aflyingcougar/elc-4438-wah-pedal/Submittal/Hardware Implementation/replacement_regulator.jpg

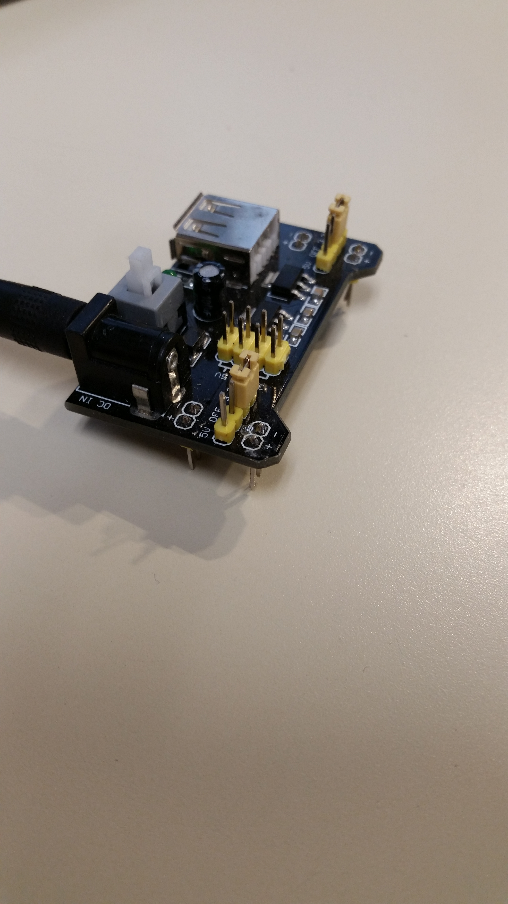
Submittal/Hardware Implementation/replacement_regulator.jpg
