aflyingcougar/elc-4438-wah-pedal/README.md

# elc-4438-wah-pedal
ELC 4438-01: Embedded Systems Final Project: DSP Wah Pedal
Contains design documentation and code implementation of a DSP wah pedal using a Teensy 3.2, a Teensy Audio board, and a re-purposed Dunlop Crybaby wah pedal enclosure.
