aflyingcougar/elc-4438-wah-pedal/Submittal/Source Code/readme.txt

See the Final Notes secion of the report for instructions on how to install/use Teensyduino.
