aflyingcougar/elc-4438-wah-pedal/Hardware Implementation/Hardware Implementation.docx

Hardware Implementation

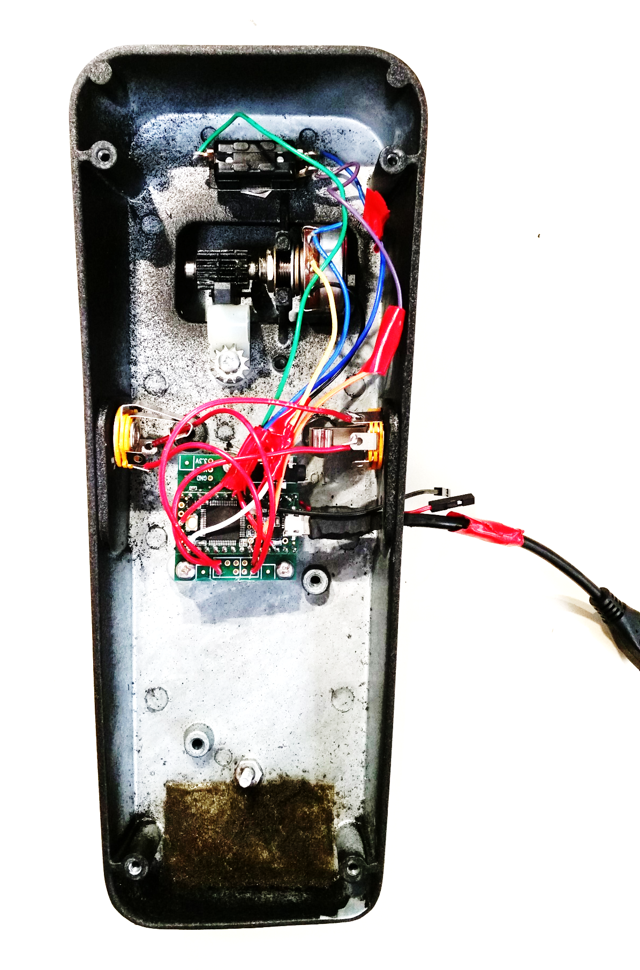
[picture p3: figure]

Switch

¼” Audio Jacks

Potentiometer

Power Supply Input

USB Cable

Teensy 3.2 and Audio Board Extension
