aflyingcougar/elc-4438-wah-pedal/Presentation/Final Presentation.pptx

## Wah Pedal

CJ Tulowiecki & Eric Walden

## What is a wah pedal?

- Electrical guitar effects pedal
- Name is an onomatopoeia, “wah-wah”
  - Mimics the human voice
- Moving pedal sweeps the cutoff frequency of a filter applied to input signal

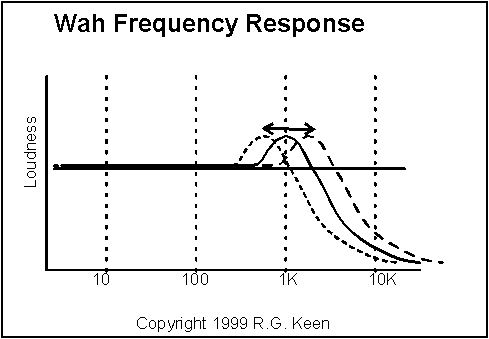
[picture p5: figure]
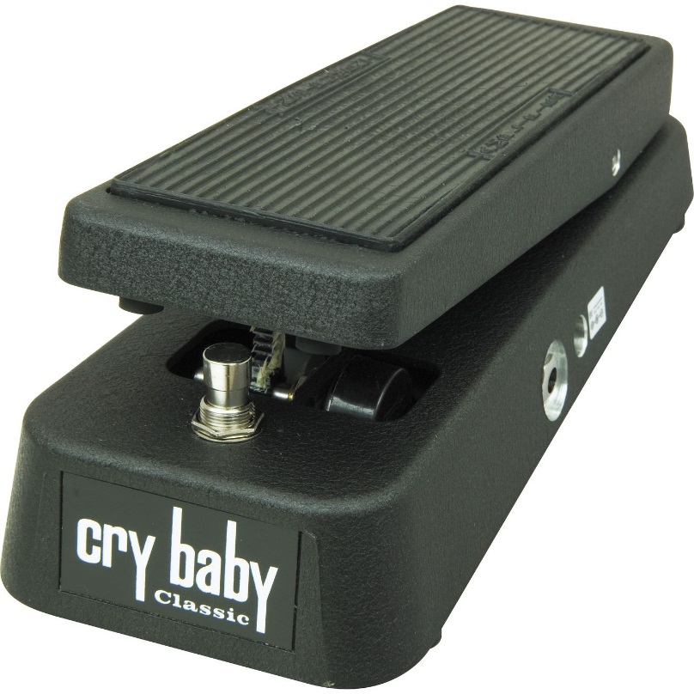
[picture p6: figure]

## Objectives

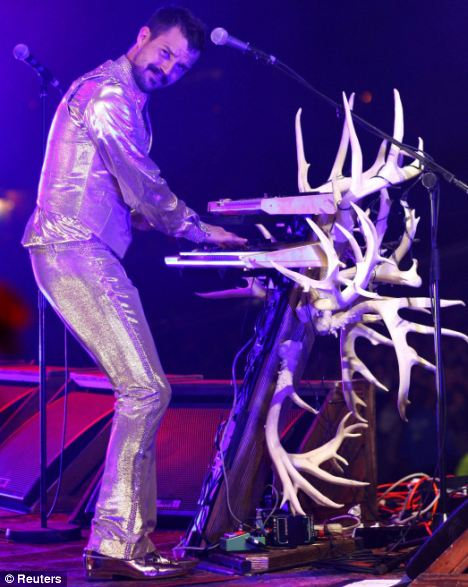
[picture p7: figure]

- Use a microcontroller to make a wah pedal
- Control cutoff frequency with the wah pedal’s potentiometer
- Learn about digital audio processing
- Make interesting sounds

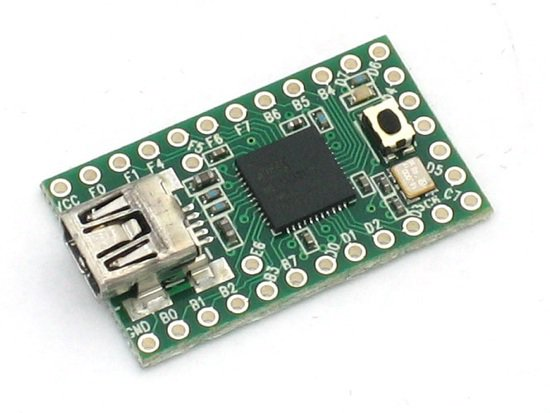
[picture p8: figure]
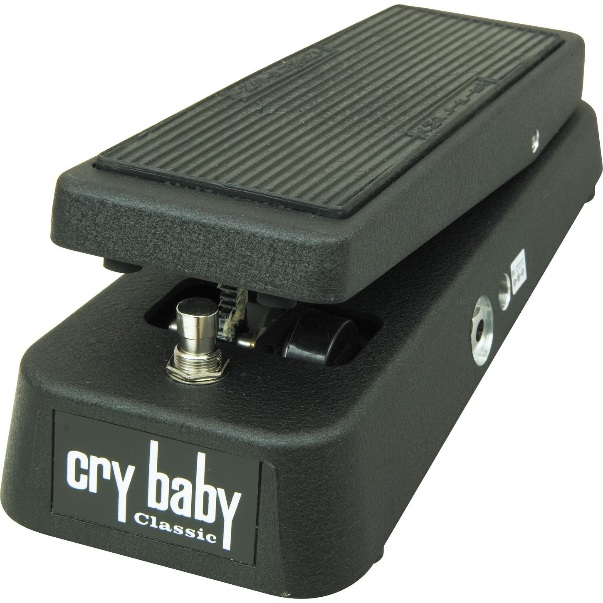
[picture p9: figure]
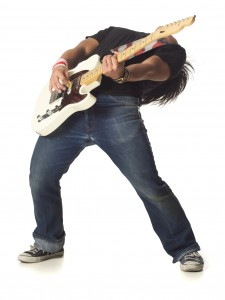
[picture p10: figure]
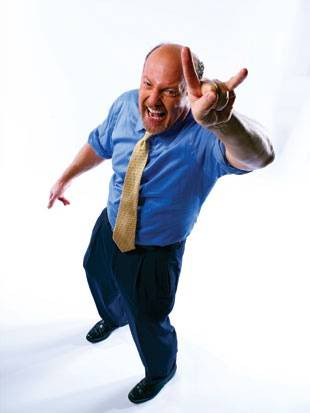
[picture p11: figure]

## Original Hardware Design

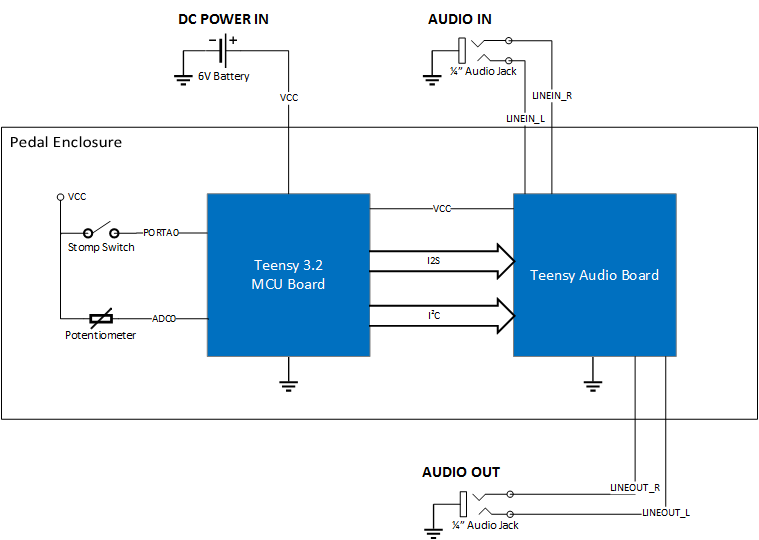
[picture p12: figure]

## Changes to Hardware

- New regulator
- Mono inputs and outputs
- USB cable

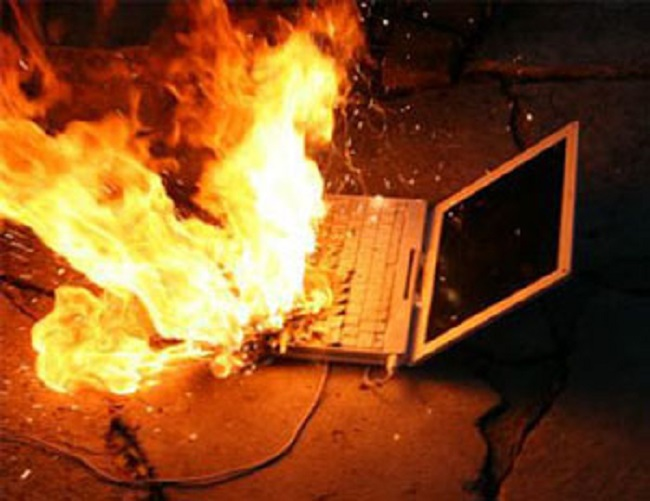
[picture p13: figure]
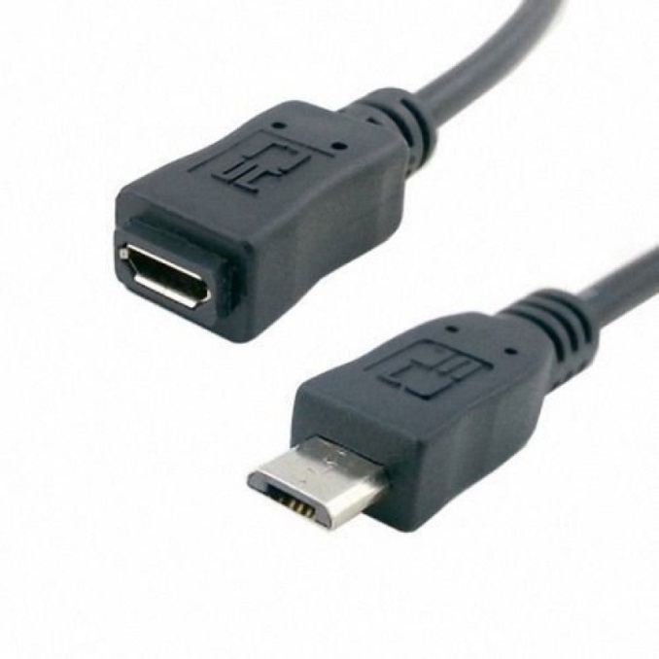
[picture p14: figure]

## Current Hardware Design

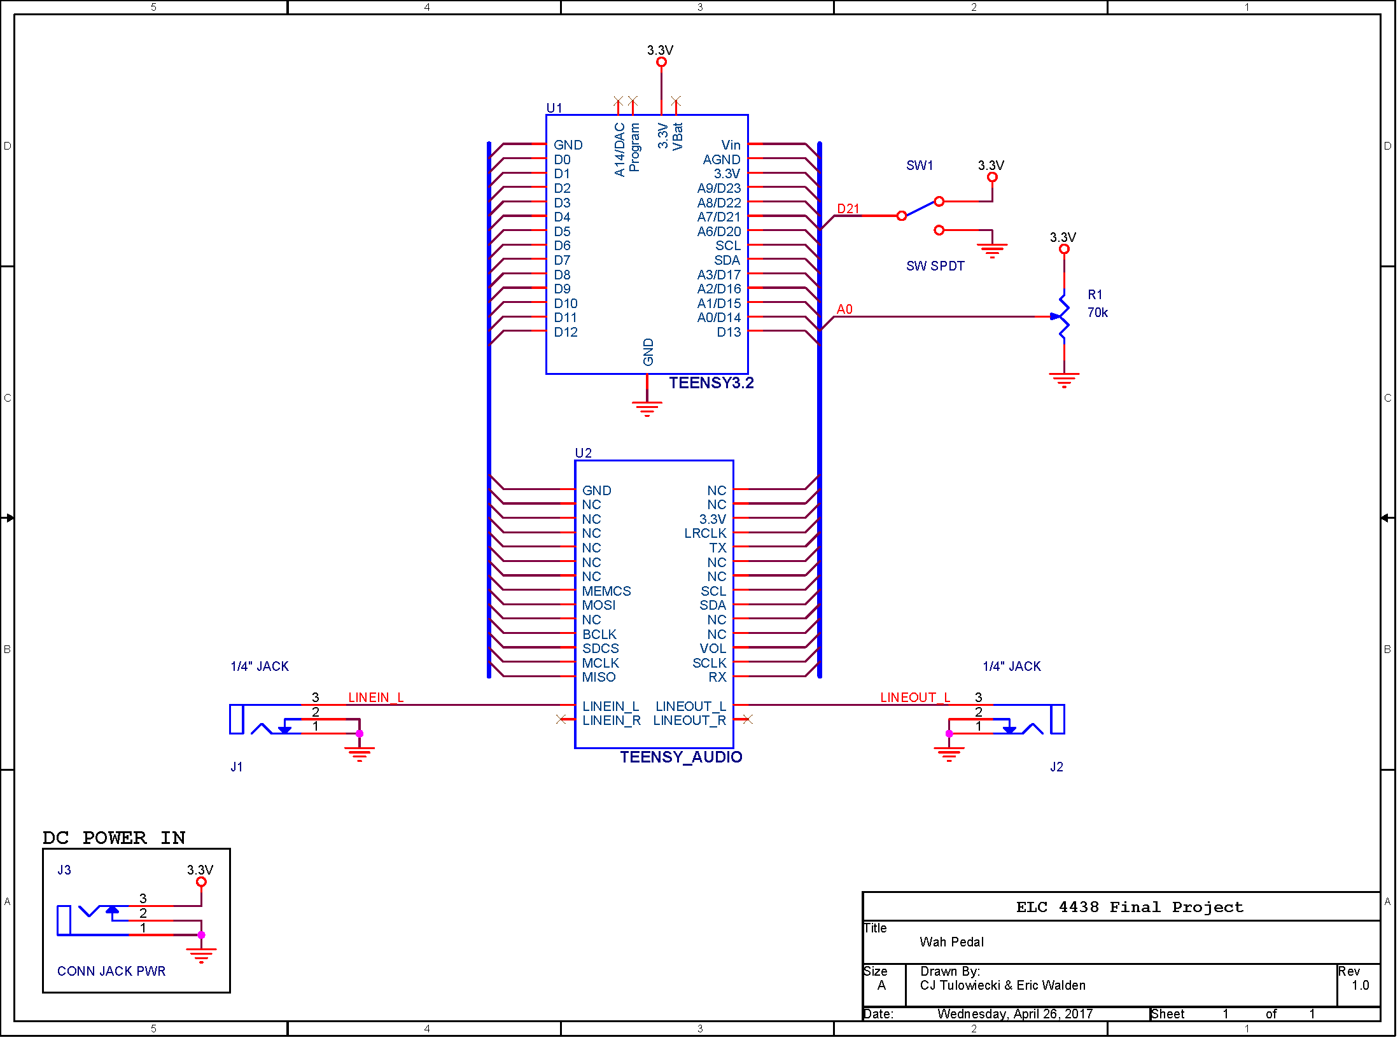
[picture p15: figure]

## Hardware Implementation

Regulator

Switch

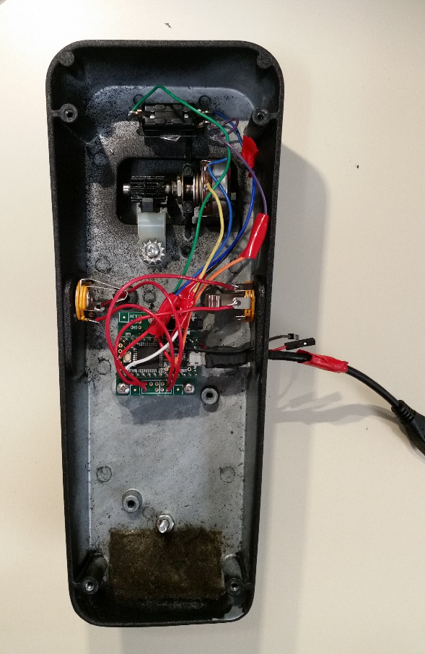
[picture p16: figure]

Potentiometer

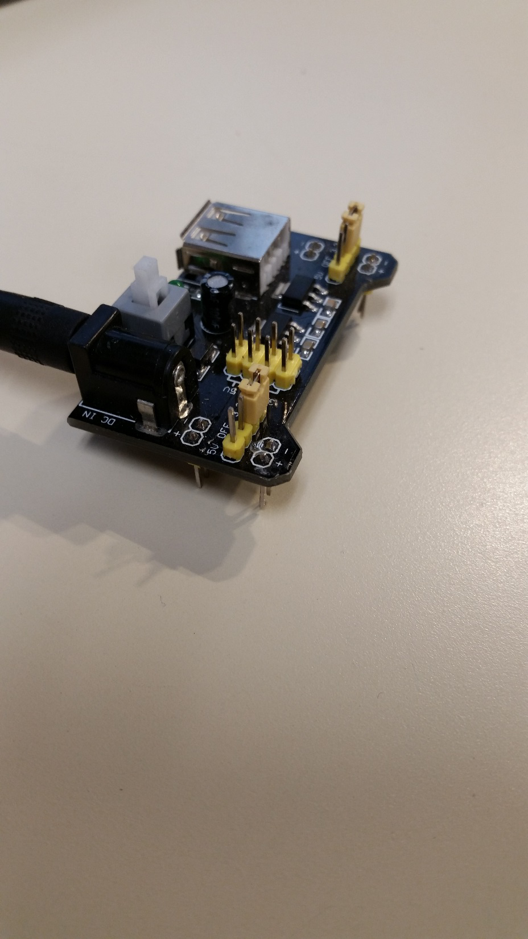
[picture p17: figure]

Jacks

Teensy

Cable

## Original Software Design

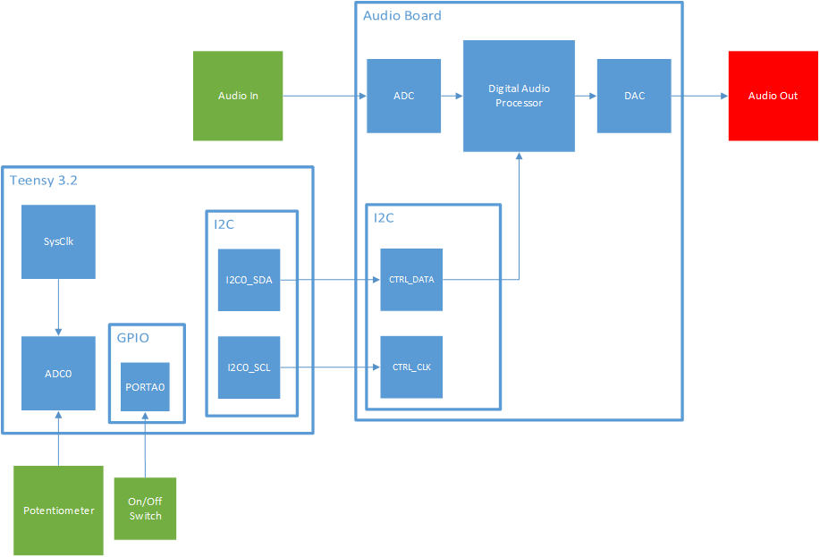
[picture p18: figure]

## Changes to Software

- Used processor on main Teensy board to process audio
- I2S between Teensy and Audio Board
- Changed GPIO pin
- Modified filter resonance and frequency sweep range to provide desired sound

## Current Software Design

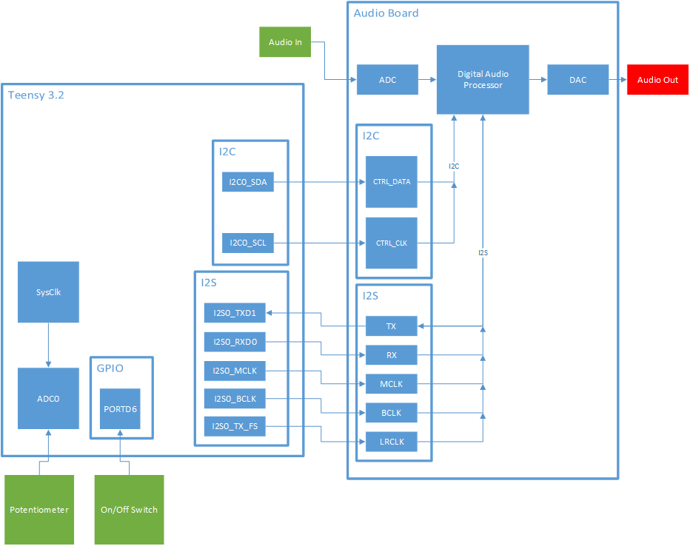
[picture p19: figure]

## Software Implementation

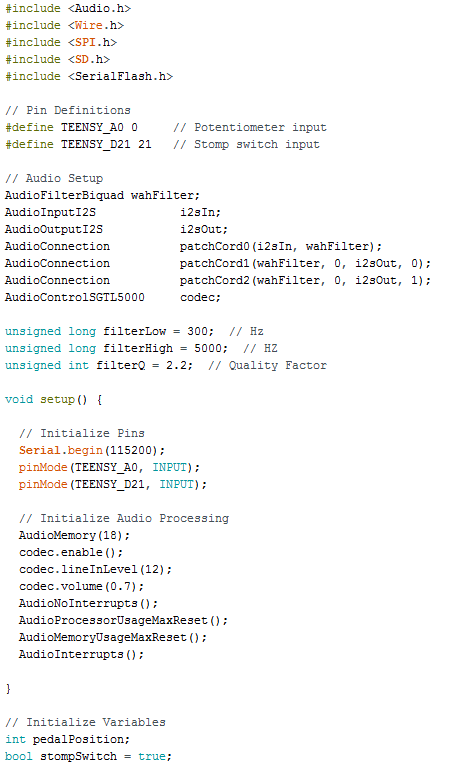
[picture p20: figure]

## Software Implementation

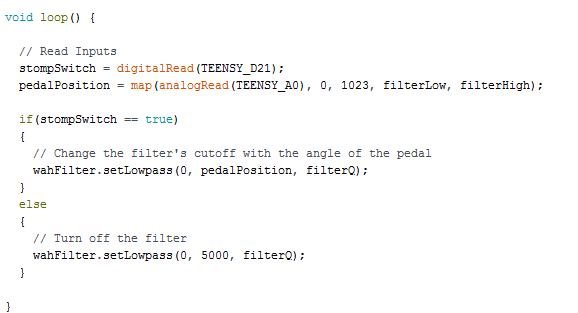
[picture p21: figure]

## Demo

## Questions?
