aflyingcougar/elc-4438-wah-pedal/Submittal/Hardware Design Documentation/Parts List.xlsx

Part Number | Description | Quantity | Link
9597 | Enclosure - Wah Pedal Shell and Hardware | 1 | https://www.amplifiedparts.com/products/enclosure-wah-pedal-shell-and-hardware
TEENSY32 | Teensy 3.2 USB Development Board | 1 | https://www.pjrc.com/store/teensy32.html
TEENSY3_AUDIO | Audio Adaptor Board for Teensy 3.0 - 3.6 | 1 | https://www.pjrc.com/store/teensy3_audio.html
SC1089-ND | 1/4" Mono Femail Headphone Jack | 2 | https://www.digikey.com/product-detail/en/switchcraft-inc/12A/SC1089-ND/109527
HEADER_14x1 | 14 pins, 0.1 inch spacing Male Header | 2 | https://www.pjrc.com/store/header_14x1.html
B010UJFVTU | Jbtek Breadboard Power Supply Module 3.3/5V | 1 | https://www.amazon.com/JBtek-Breadboard-Supply-Arduino-Solderless/dp/B010UJFVTU
