aflyingcougar/elc-4438-wah-pedal/Hardware Design Documentation/Schematic/schematic.pdf

## TEENSY3.2

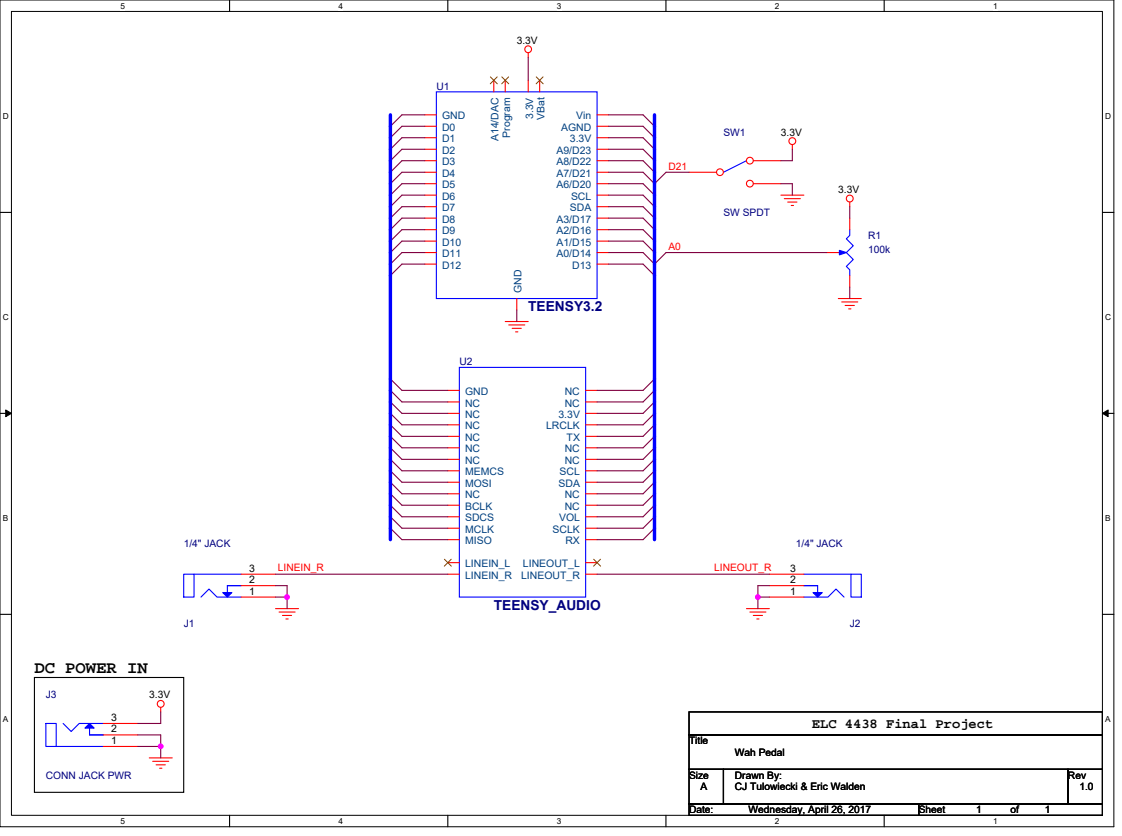
[picture p22: page 1]

Size Size Size A A A | Drawn By: Drawn By: Drawn By: CJ Tulowiecki & Eric Walden CJ Tulowiecki & Eric Walden CJ Tulowiecki & Eric Walden | Rev Rev Rev 1.0 1.0 1.0

Date: Date: Date: Wednesday, April 26, 2017 Wednesday, April 26, 2017 Wednesday, April 26, 2017 | Sheet Sheet Sheet 1 1 1 of of of 1 1 1
