aflyingcougar/elc-4438-wah-pedal/(list of files, drawings)

Other design files:
Submittal/Hardware Design Documentation/Schematic Project/WAHPEDAL.DSN
Submittal/Hardware Design Documentation/Schematic Project/WAHPEDAL.OLB
Submittal/Hardware Design Documentation/Schematic Project/WahPedal.opj
