aflyingcougar/elc-4438-wah-pedal/Task Breakdown and Test Plan.docx

# Tasks

1. Connect to Audio Board
2. Implement Static Digital Filter
3. Test Potentiometer ADC Read on Teensy MCU
4. Implement Dynamic Digital Filter
5. Mount Current Hardware in Pedal Enclosure
6. Implement Additional Features

# Test Plan

1. Task 1: Connect to Audio Board
  a. Test Line-Level Audio I/O
    i. Run audio signal to the input of the Audio Board.
    ii. Confirm that audio signal is received at the output port.
2. Task 2: Implement Static Digital Filter
  a. Modify Parametric EQ on Audio Board to behave as a low-pass filter at a fixed cutoff frequency.
3. Task 3: Test Potentiometer ADC Read on Teensy MCU
  a. Connect potentiometer to Teensy MCU ADC input.
  b. Print encoded voltage samples to serial console.
4. Task 4: Implement Dynamic Digital Filter
  a. Verify that the potentiometer can vary Digital Filter cutoff frequency using I2C.
5. Task 5: Mount Current Hardware in Pedal Enclosure
  a. Perform continuity checks on electrical connections.
  b. Perform visual check on quality of installation.
6. Task 6: Implement Additional Features
  a. Attempt to overdrive filter while Teensy is installed in pedal enclosure.
  b. Confirm ease of modification without disassembling enclosure.
