aflyingcougar/elc-4438-wah-pedal/Source Code/WahPedal/WahPedal.ino

#include <Audio.h>
#include <Wire.h>
#include <SPI.h>
#include <SD.h>
#include <SerialFlash.h>

// Pin Definitions
#define TEENSY_A0 0     // Potentiometer input
#define TEENSY_D21 21   // Stomp switch input

// Audio Setup
AudioFilterBiquad wahFilter;
AudioInputI2S            i2sIn;
AudioOutputI2S           i2sOut;          
AudioConnection          patchCord0(i2sIn, wahFilter);
AudioConnection          patchCord1(wahFilter, 0, i2sOut, 0);
AudioConnection          patchCord2(wahFilter, 0, i2sOut, 1);
AudioControlSGTL5000     codec; 

unsigned long filterLow = 300;  // Hz
unsigned long filterHigh = 5000;  // HZ
unsigned int filterQ = 2.2;  // Quality Factor


  

void setup() {
  
  // Initialize Pins
  Serial.begin(115200);
  pinMode(TEENSY_A0, INPUT);
  pinMode(TEENSY_D21, INPUT);

  // Initialize Audio Processing
  AudioMemory(18);  
  codec.enable();  
  codec.lineInLevel(12); 
  codec.volume(0.7);
  AudioNoInterrupts();
  AudioProcessorUsageMaxReset();
  AudioMemoryUsageMaxReset();
  AudioInterrupts();

}

// Initialize Variables
int pedalPosition;
bool stompSwitch = true;

void loop() {

  // Read Inputs
  stompSwitch = digitalRead(TEENSY_D21);
  pedalPosition = map(analogRead(TEENSY_A0), 0, 1023, filterLow, filterHigh);

  if(stompSwitch == true)
  {
    // Change the filter's cutoff with the angle of the pedal
    wahFilter.setLowpass(0, pedalPosition, filterQ);
  }
  else
  {
    // Turn off the filter
    wahFilter.setLowpass(0, 5000, filterQ);
  }

}
