aflyingcougar/elc-4438-wah-pedal/(commit log)

2017-04-26 added schematic files
    [WAHPEDAL.DSN, WAHPEDAL.OLB, WahPedal.opj]
2017-04-26 added SPDT switch code
    [WAHPEDAL.DSN, WAHPEDAL.OLB, WahPedal.opj]
2017-04-26 updated schematic
    [WAHPEDAL.DSN, WAHPEDAL.OLB, WahPedal.opj]
2017-04-26 exported schematic to pdf
    [WAHPEDAL.DSN, WahPedal.opj]
2017-04-27 added prop doc
2017-05-06 preparing for final submittal
    [Parts List.xlsx, WAHPEDAL.DSN, WAHPEDAL.OLB, WahPedal.opj]
2017-05-06 put together submittal. needs pic of pedal closed up
    [Parts List.xlsx, WAHPEDAL.DSN, WAHPEDAL.OLB, WahPedal.opj]
