aflyingcougar/elc-4438-wah-pedal/Submittal/Hardware Implementation/modified_pedal.jpg

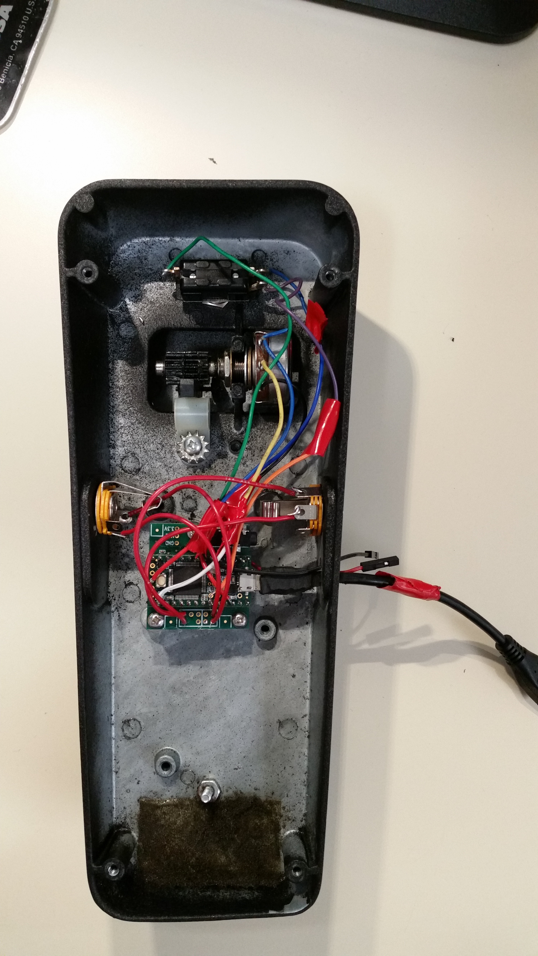
Submittal/Hardware Implementation/modified_pedal.jpg
